Tottocs/B37VB-2024-Edi-Robotics-Group-3/README.md

# B37VB-2024-Edi-Robotics-Group-3
## Torin Stanton-Andersson and David Mariani 
## Robot
