Tottocs/B37VB-2024-Edi-Robotics-Group-3/docs/final-report/pictures/robot/20240414_152319.PNG

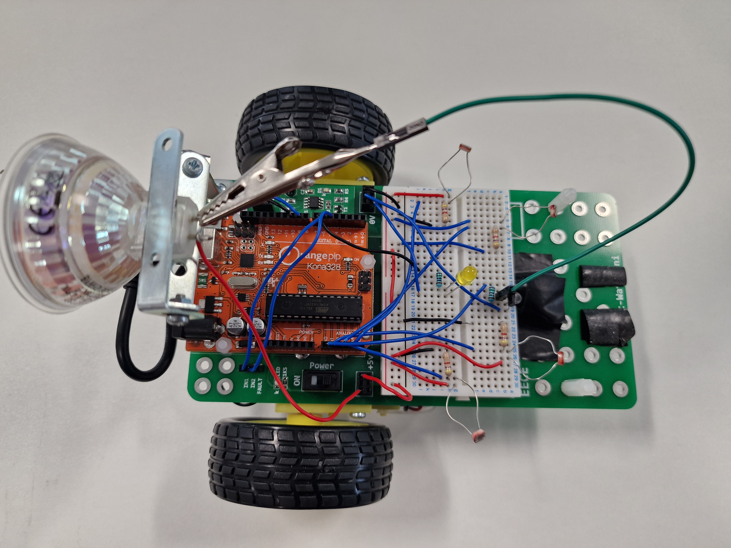
docs/final-report/pictures/robot/20240414_152319.PNG
