Tottocs/B37VB-2024-Edi-Robotics-Group-3/sims/ldr-circuit/ldr-circuit.asc

R1: Res; {LDR}
R2: Res; {RES}
V1: voltage; 5
Named nets: 0
.tran 1
.step param LDR list 100 10k 100k 250k 500k
.step param RES list 1k 10k 100k 250k
