Tottocs/B37VB-2024-Edi-Robotics-Group-3/src/Arduino Motor Test code.ino

//C code on Arduino UNO

#define MOT_A1_PIN 5
#define MOT_A2_PIN 6
#define MOT_B1_PIN 9
#define MOT_B2_PIN 10
#define ONTIME 1500

int leftServoSpeed = 200;
int rightServoSpeed = 200;

void setup() {
  pinMode(MOT_A1_PIN, OUTPUT);
  pinMode(MOT_A2_PIN, OUTPUT);
  pinMode(MOT_B1_PIN, OUTPUT);
  pinMode(MOT_B2_PIN, OUTPUT);

  digitalWrite(MOT_A1_PIN, LOW);
  digitalWrite(MOT_A2_PIN, LOW);
  digitalWrite(MOT_B1_PIN, LOW);
  digitalWrite(MOT_B2_PIN, LOW);
  
  Serial.begin(9600);
}

void set_motor_pwm(int pwm, int IN1_PIN, int IN2_PIN)
{
  if (pwm < 0) {  // reverse speeds
    analogWrite(IN1_PIN, -pwm);
    digitalWrite(IN2_PIN, LOW);

  } else { // stop or forward
    digitalWrite(IN1_PIN, LOW);
    analogWrite(IN2_PIN, pwm);
  }
}

void set_motor_currents(int pwm_A, int pwm_B)
{
  set_motor_pwm(pwm_A, MOT_A1_PIN, MOT_A2_PIN);
  set_motor_pwm(pwm_B, MOT_B1_PIN, MOT_B2_PIN);

  // Print a status message to the console.
  Serial.print("Set motor A PWM = ");
  Serial.print(pwm_A);
  Serial.print(" motor B PWM = ");
  Serial.println(pwm_B);
}

void spin_and_wait(int pwm_A, int pwm_B, int duration)
{
  set_motor_currents(pwm_A, pwm_B);
  delay(duration);
}

void loop()
{

  spin_and_wait(leftServoSpeed,rightServoSpeed,ONTIME); // sets speed of motors to value entered above for 0.5 sec and keeps repeating
}
