Tottocs/B37VB-2024-Edi-Robotics-Group-3/(commit log)

2024-02-29 Create Arduino Motor Test code
2024-03-13 Rename Arduino Motor Test code to Arduino Motor Test code.ino
2024-03-13 Rename Arduino Motor Test code.ino to Arduino Motor Test code
2024-03-21 Finalized turning
    Buggy stopped working, but code should work.
    [Forward.ino, Spin.ino, Torinos_babey.ino]
2024-03-27 Name changed
    Forward changed to open-loop-motor-control
2024-03-27 Update open-loop-motor-control.md
    Table of values for motor Characterization
2024-04-01 Update open-loop-motor-control.ino
    This version of the program should work. The only aspect that should be added is an LED
2024-04-02 Revert "Update open-loop-motor-control.ino"
    This reverts commit 47ca4502999b068fb2deaf7cfae7967a7d53dcc8.
    [open-loop-motor-control.ino]
2024-04-03 Added PWM Pictures
    Added pictures from PWM of Motors
2024-04-03 Update open-loop-motor-control.md
    Table created
2024-04-03 Open loop motor control finished
    Version 1.0 complete
2024-04-03 Update open-loop-motor-control.md
    Finished text work
2024-04-03 Update open-loop-motor-control.md
    Fixed hashes
2024-04-03 Update open-loop-motor-control.md
    Fixed Header
2024-04-03 Update open-loop-motor-control.md
    Fixed Title
2024-04-03 Update open-loop-motor-control.md
    Finalised Formatting
2024-04-03 Rename open-loop-motor-control.md to open-loop-motor-control-report.md
    Fixed file name
2024-04-03 Update open-loop-motor-control-report.md
    Final fixes
2024-04-13 Update open-loop-motor-control-report.md
    Changed average values to correct ones and fixed spelling
2024-04-13 Rename src/Arduino Motor Test code.ino to src/unused/arduino_motor_test_code/arduino_motor_test_code.ino
